ghmartin77/ESP8266_BME280/(threads)

Thread 1 (2019-02-05):

ch340 usb enable mod

coelner, 2019-02-05:
Hey,

I tried an another way to get rid of the ch340 power drain. I lifted the Pin4 (V3) and Pin 16 (VCC). Vcc was then bound to VUSB between the protection diode. Between Pin4 and GND is a 100nF capacitor.
The LDO was replaced with a HT7333, the enable pin is tied to 5V, the power supply is done over a LiIon battery.

Sadly the deepsleep does not work properly. It runs for a while, but suddenly it stops working. Somehow the trigger signal is not strong enough. I'm not sure why this is happen, I suspect the CH340 as evil. The deepsleep sometimes works for hours, but mostly one some sleeps.

Any hint?

coelner, 2019-02-08:
Problem solved, counterfeit chip caused problems

Closed 2019-02-08.

Thread 2 (2020-06-04):

CR123a

bpbastos, 2020-06-04:
Hello @ghmartin77

It's not really an issue, but I'd like to know if you have any info about how long it last on cr123a battery.

Thanks

ghmartin77, 2020-06-04:
Hi @bpbastos,

Depends on several things like temperature changes, configuration parameters, Wifi connectivity, battery make. For my typical environment it's about 6 months.

Here's a graph of VCC of the last year. You can see the first battery was replaced in Jan'20 after powering the device from Jul'19 to Dec'20.

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

Hope this helps.

Best regards,
ghmartin77

bpbastos, 2020-06-05:
Thank you @ghmartin77 it'll help a lot! Do you mind share the update frequency?

Bests

ghmartin77, 2020-06-05:
It's running with the configuration as preset in https://github.com/ghmartin77/ESP8266_BME280/blob/master/ESP8266_BME280/defines.h

Closed 2020-06-06.

Thread 3 (2020-06-28):

Readme Request: More info on parts being removed.

ChrisWeiss, 2020-06-28:
Looks very slick, can you go into more detail on what the parts are you're removing and why (I get the LED, but what about the resistor and desoldering the pins on the chip?)

ghmartin77, 2020-07-22:
Hi Chris,

(100K) Resistor is removed to make ESP.getVCC() work properly. For details see here: https://github.com/esp8266/Arduino/issues/721#issuecomment-296994054
The pins of the CH340C are removed to disable power supply for the (not needed) USB2UART chip. You can also remove the chip completely.
Wemos D1 mini schematics are available here for further reference: https://docs.wemos.cc/en/latest/_static/files/sch_d1_mini_v3.0.0.pdf

Best regards,
ghmartin77

Closed 2020-08-04.
